plumpastry/PHW/README.md

# **P**lum's **H**ard**W**are

PHW-Board#-Part#-Revision#

## PHW-1-1-2:


NFC smartwatch development board

## PHW-1-1-1:



NFC smartwatch original board - infeasible manual assembly due to STM32WL
