plumpastry/PHW/nfc-watch/firmware/drv2625/readme.md

# A simple WIP Texas instruments DRV2625 driver
