plumpastry/PHW/nfc-watch/hardware/bom/pcb_bom.xlsx

Designator | Footprint | Quantity | Designation | Supplier and ref | Mouser P/N | Stock | Notes | Quantity Needed
C41,C42 | C_0402_1005Metric | 2 | 620pF |  | 81-GCM1555C1H621GA6D | 18 | 50VDC | 0
R7,R15,R4,R14,R8,R16 | R_0402_1005Metric | 6 | R10K |  | 71-CRCW040210K0FKEDC | 40 |  | 0
C24,C18,C37,C15,C23,C10,C14,C22,C9,C25 | C_0402_1005Metric | 10 | C0.1uF |  | 81-GRM15R61A104KA01J | 40 |  | 0
R1 | R_0402_1005Metric | 1 | R15k |  | 667-ERJ-PA2F1502X |  |  | 1
C38 | C_0402_1005Metric | 1 | C1uF |  | 81-GRM155C71C105ME11 | 9 |  | 0
PLUM FEEDBACK ENGINE | PUI_HD-LA0503-LW28 | 1 | HD-LA0503-LW28 |  | 665-HD-LA0503-LW28 | 1 |  | 0
C55 | C_0201_0603Metric | 1 | C0.3pF |  | 81-GCQ0335C1HR30BB1D |  |  | 1
C30,C32,C28,C34,C27,C36 | C_0201_0603Metric | 6 | C10nF |  | 963-JMK063BJ103KP-F |  | NFC DECOUPLING | 6 | NOTE: some parts footprints are wrong!!
C44,C43,C45,C1 | LXRW0YV201059 | 4 | LXRW0YV201-059 |  | 81-LXRW0YV201-059 | 0 |  | 4 | ALSO DECOUPLING PARTS FOR NFC MUSTS BE 6V RATED
IC4 | QFN50P400X400X90-25N-D | 1 | NPM1100-QDAA-R |  | 949-NPM1100-QDAA-R | 1 |  | 0
C4,C51,C8,C26,C3 | C_0402_1005Metric | 5 | C2.2uF |  | 81-GRT155R60J225KE1J |  |  | 5
C16,C29,C31,C33,C35 | C_0201_0603Metric | 5 | C2.2uF |  | 81-GRM033R60J225ME1D |  | NFC DECOUPLING | 5
C49,C47 | C_0402_1005Metric | 2 | 220pF |  | 81-GCM1555C2A221JE2D | 18 | 100VDC | 0
J3,J6,J5 | PinHeader_1x02_P2.54mm_Vertical | 3 | Conn_01x02_Pin |  | 649-1012937890203BLF |  |  | 3
C46,C48 | C_0402_1005Metric | 2 | 10pF |  | 81-GRM1555C2A100FA1D | 18 | 100VDC | 0
Y2 | Crystal_SMD_2016-4Pin_2.0x1.6mm | 1 | 32MHz |  | 581-CX2016SA32DFPLG1 |  |  | 1
C6,C2,C21,C5 | C_0402_1005Metric | 4 | C10uF |  | 81-GRM155R60J106ME8D | 7 | 10VDC FOR 9V RAIL | 0
IC3 | LSM6DS3USTR | 1 | ISM330DHCXTR |  | 511-ISM330DHCXTR |  |  | 1
R12,R11 | R_0402_1005Metric | 2 | R1.6 |  | 755-ESR01MZPJ1R6 | 8 |  | 0
C7, C17,C13,C11 | R_0402_1005Metric | 4 | C4.7uF |  | 81-GRM15D81C475ME15D | 0 |  | 4
PS1 | BGA6C40P2X3_88X123X62 | 1 | TPS61046YFFR |  | 595-TPS61046YFFR | 2 |  | 0
C50 | C_0402_1005Metric | 1 | C2.2nF |  | 710-885012205008 | 4 |  | 0
L4,L3 | L_0402_1005Metric | 2 | LEMC1 |  | 710-7447650227 |  |  | 2
R3 | C_0402_1005Metric | 1 | R1k |  | 603-RC0402FR-7D1KL |  |  | 1
J4 | PinHeader_2x10_P2.54mm_Vertical | 1 | Conn_02x10_Odd_Even |  | 649-1012938192001BLF | 0 |  | 1
C52 | C_0402_1005Metric | 1 | C3.9pF |  | KGM05ACG1H3R9BH | 0 |  | 1
ANT1 | ANTENNA_W3008 | 1 | W3008 |  | 673-W3008 | 0 |  | 1
TH1 | C_0201_0603Metric | 1 | NTC |  | 810-NTCG063JF103FT | 3 |  | 0
C39,C40 | C_0402_1005Metric | 2 | C12pF |  | 81-GRT1555C2A120JA2D | 16 |  | 0
Y1 | XRCGB | 1 | XRCGB27M120F3M13R0 |  | 81-XRCGB27M120F3M13R | 9 | 100VDC | 0
C53 | C_0201_0603Metric | 1 | C1.5pF |  | 81-GJM0335C1E1R5WB1D |  |  | 1
L2 | L_1008_2520Metric | 1 | L10uH |  | 81-1239AS-H-100MP2 | 3 |  | 0
AE1 | C_0805_2012Metric_Pad1.18x1.45mm_HandSolder | 1 | Antenna_Loop |  | 538-146236-0101 | 2 |  | 0
FB1 | L_0402_1005Metric | 1 | FerriteBead |  | 810-MPZ1005A151ETD25 | 3 |  | 0
FB2 | L_0402_1005Metric | 1 | FerriteBead |  | 81-BLM15AG121SN1D |  |  | 1
R6 | R_0402_1005Metric | 1 | R510K |  | 71-CRCW0402510KFKED | 9 |  | 0
L8,L7 | C_0402_1005Metric | 2 | L3.5nH |  | 81-LQP03HQ3N5B02D |  |  | 2
R5 | R_0402_1005Metric | 1 | R75K |  | 71-RCG040275K0JNED | 9 |  | 0
L6 | C_0402_1005Metric | 1 | L2.7nH |  | 81-LQP03HQ2N7B02D |  |  | 1
SW4,SW3,SW2 | SW_B3U-1100P | 3 | SW_Push |  | 653-B3U-1100P |  |  | 3
IC2 | QFN50P500X500X60-33N-D | 1 | ST25R3916B-AQET |  | 511-ST25R3916B-AQET | 1 |  | 0
J2 | 2121340002 | 1 | 212134-0002 |  | 538-212134-0002 | 3 |  | 0
C54 | C_0201_0603Metric | 1 | C2.0pF |  | 81-GJM0335C1E2R0WB1D |  |  | 1
L1 | L_0805_2012Metric | 1 |  |  | 810-MLP2012V2R2MT0S1 | 3 |  | 0
L5 | L_0603_1608Metric | 1 | L4.7uH |  | 81-LQM18PH4R7MFRL |  |  | 1
R2 | R_0402_1005Metric | 1 | R750K |  | 71-CRCW0402750KFKEDC | 9 |  | 0
U2 | QFN-48-1EP_6x6mm_P0.4mm_EP4.6x4.6mm | 1 | NRF54L15-QFAA-R |  | 949-NRF54L15-QFAA-R | 0 |  | 1
SW1 | alps_ec05e | 1 | RotaryEncoder |  | 688-EC05E1220202 | 0 |  | 1
IC1 | BGA9C40P3X3_147X133X62 | 1 | DRV2625YFFR |  | 595-DRV2625YFFR | 2 |  | 0
