plumpastry/PHW/nfc-watch/hardware/symbols/alps/EC05E1220202/ec05e1220202.obj

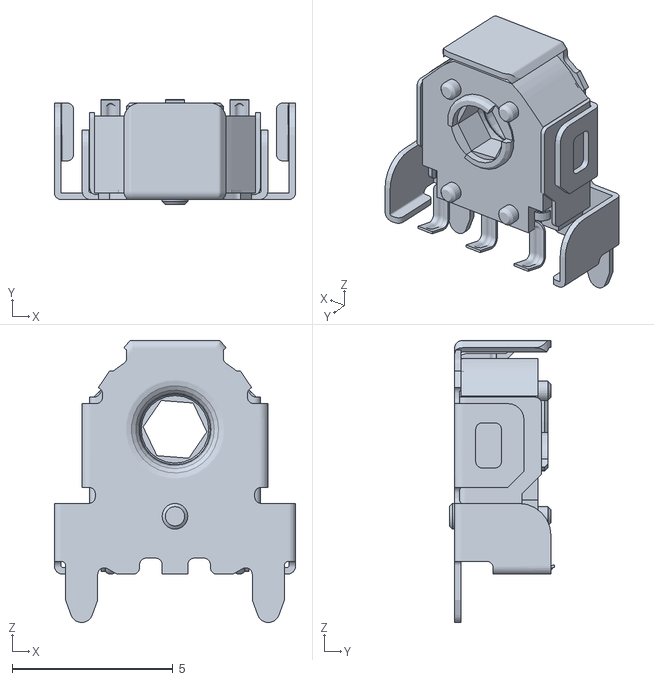
[picture p1: CAD file, 2026-02-17]
nfc-watch/hardware/symbols/alps/EC05E1220202/ec05e1220202.obj
7.50 x 3.27 x 8.76
