plumpastry/PHW/nfc-watch/hardware/symbols/B3U_1100P/B3U-1100P.step

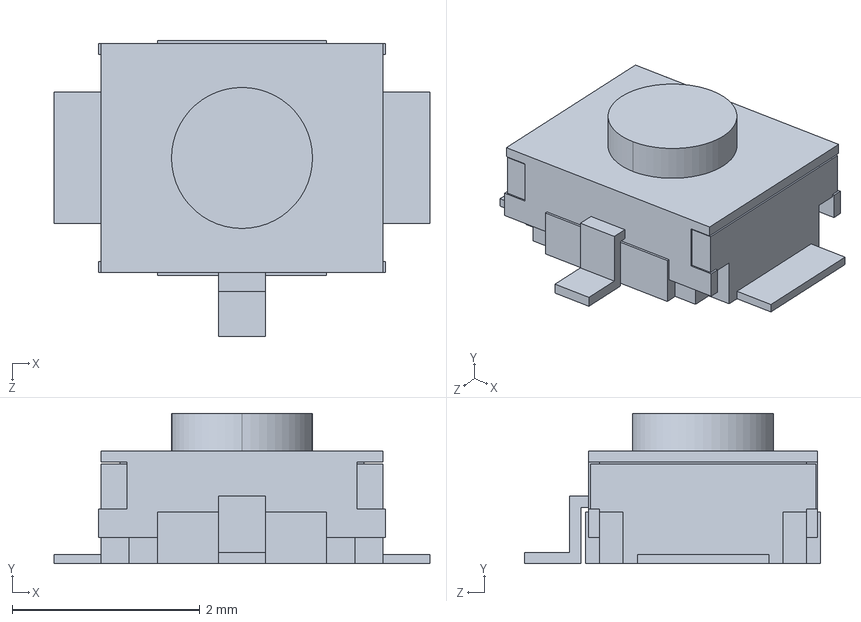
[picture p2: CAD file, 2026-02-17]
nfc-watch/hardware/symbols/B3U_1100P/B3U-1100P.step
4.00 x 1.60 x 3.15 mm
