plumpastry/PHW/nfc-watch/hardware/symbols/CX90B_16P1(2)/CX90B-16P1.step

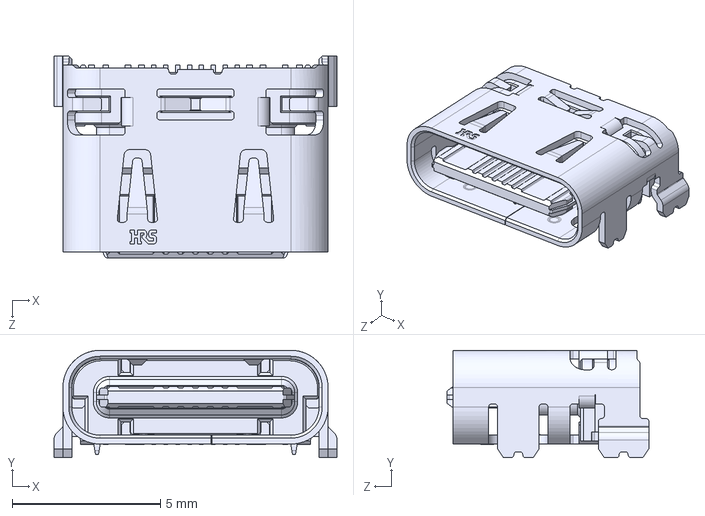
[picture p3: CAD file, 2026-02-17]
nfc-watch/hardware/symbols/CX90B_16P1(2)/CX90B-16P1.step
9.54 x 3.62 x 6.80 mm
