plumpastry/PHW/nfc-watch/hardware/symbols/disp.obj

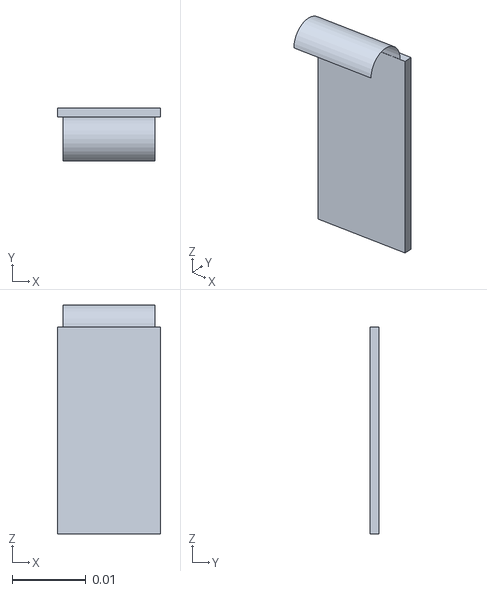
[picture p4: CAD file, 2026-02-17]
nfc-watch/hardware/symbols/disp.obj
0.014 x 0.00724 x 0.031
