plumpastry/PHW/nfc-watch/hardware/symbols/HD_LA0503_LW28/HD-LA0503-LW28.step

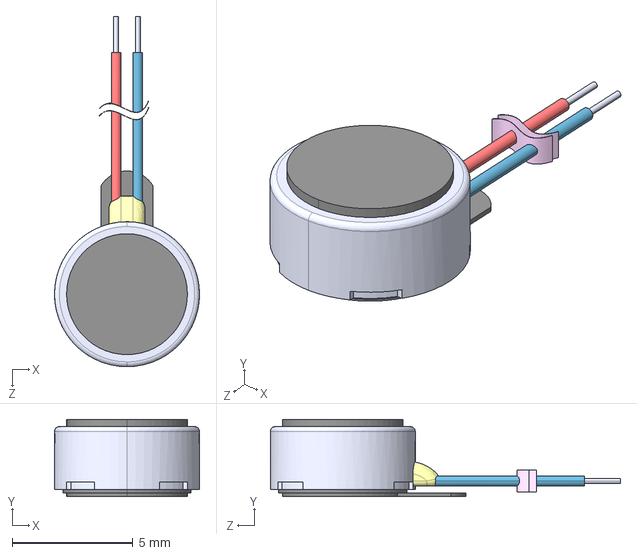
[picture p5: CAD file, 2026-02-17]
nfc-watch/hardware/symbols/HD_LA0503_LW28/HD-LA0503-LW28.step
6.00 x 3.20 x 14.5 mm
