plumpastry/PHW/nfc-watch/hardware/symbols/LIB_DRV2625YFFR/DRV2625YFFR/3D/DRV2625YFFR.stp

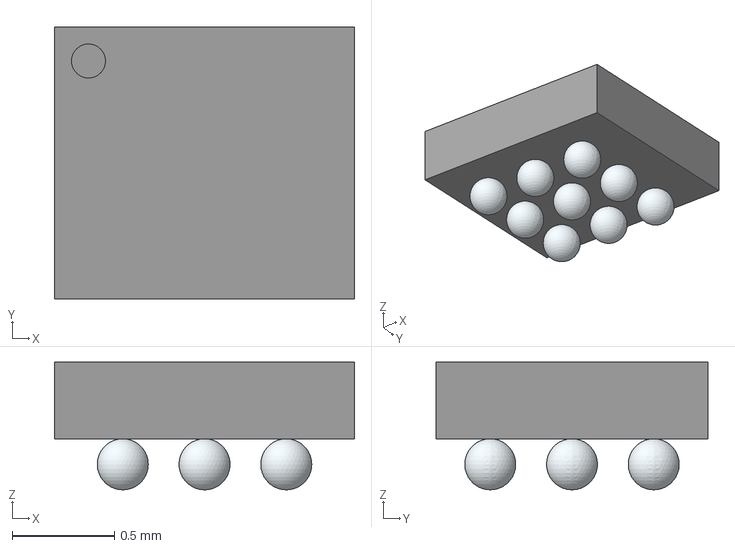
[picture p6: CAD file, 2026-02-17]
nfc-watch/hardware/symbols/LIB_DRV2625YFFR/DRV2625YFFR/3D/DRV2625YFFR.stp
1.47 x 1.33 x 0.625 mm
