plumpastry/PHW/nfc-watch/hardware/symbols/LIB_ISM330DHCXTR(1)/ISM330DHCXTR/3D/ISM330DHCXTR.stp

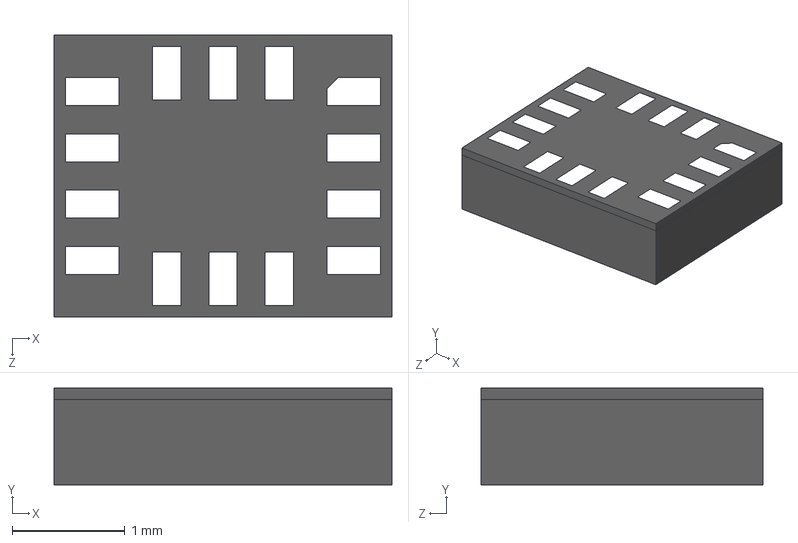
[picture p7: CAD file, 2026-02-17]
nfc-watch/hardware/symbols/LIB_ISM330DHCXTR(1)/ISM330DHCXTR/3D/ISM330DHCXTR.stp
3.00 x 0.86 x 2.50 mm
