plumpastry/PHW/nfc-watch/hardware/symbols/LIB_NPM1100-QDAA-R/NPM1100-QDAA-R/3D/NPM1100-QDAA-R.stp

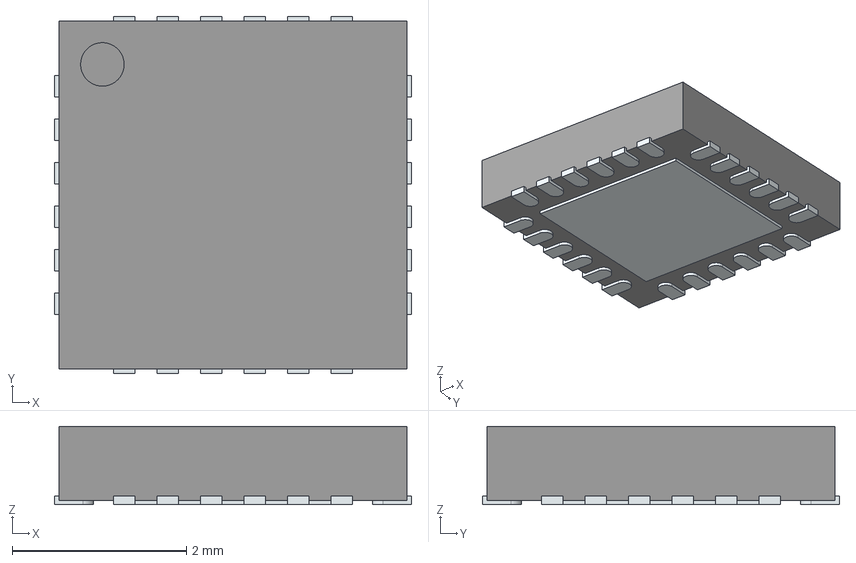
[picture p8: CAD file, 2026-02-17]
nfc-watch/hardware/symbols/LIB_NPM1100-QDAA-R/NPM1100-QDAA-R/3D/NPM1100-QDAA-R.stp
4.10 x 4.10 x 0.9 mm
ThermalPin
PinsArrayLR
PinsArrayTB
