plumpastry/PHW/nfc-watch/hardware/symbols/LIB_ST25R3916B-AQET(1)/ST25R3916B-AQET/3D/ST25R3916B-AQET.stp

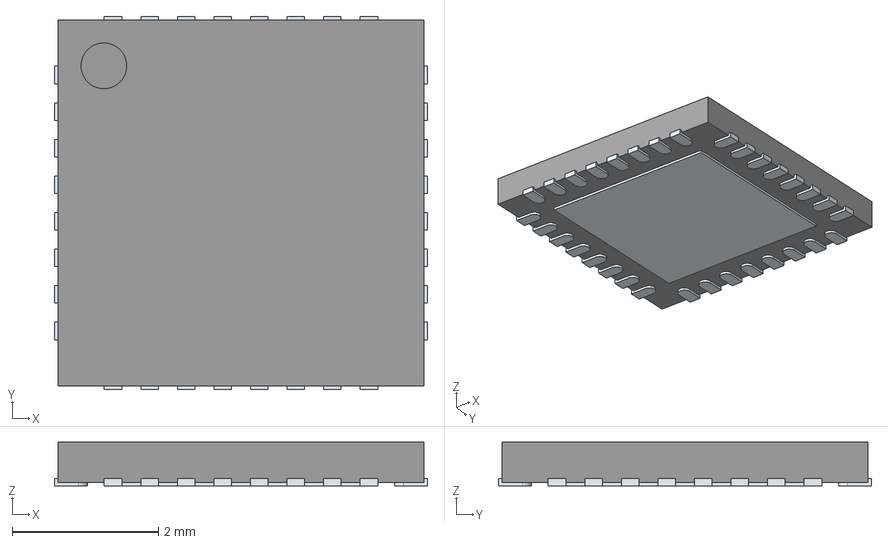
[picture p9: CAD file, 2026-02-17]
nfc-watch/hardware/symbols/LIB_ST25R3916B-AQET(1)/ST25R3916B-AQET/3D/ST25R3916B-AQET.stp
5.10 x 5.10 x 0.6 mm
ThermalPin
PinsArrayLR
PinsArrayTB
