plumpastry/PHW/nfc-watch/hardware/symbols/LIB_ST25R3916B-BWLT/ST25R3916B-BWLT/3D/ST25R3916B-BWLT.stp

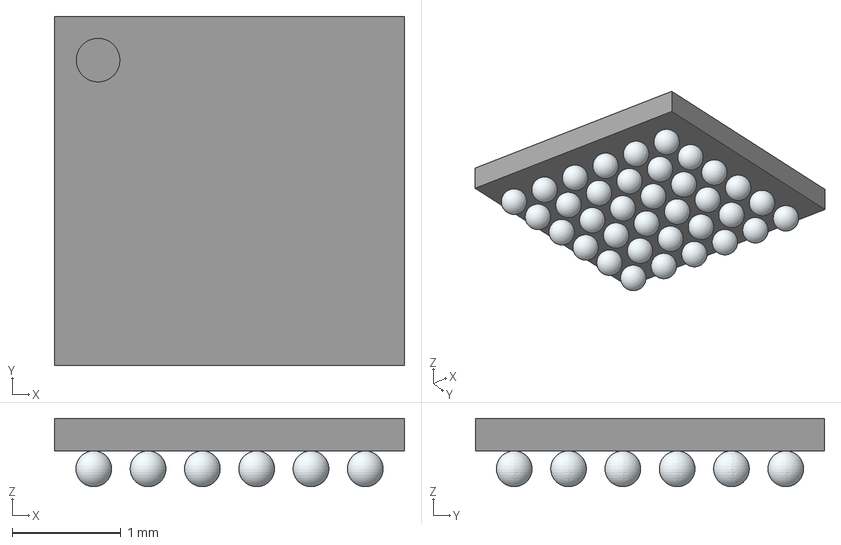
[picture p10: CAD file, 2026-02-17]
nfc-watch/hardware/symbols/LIB_ST25R3916B-BWLT/ST25R3916B-BWLT/3D/ST25R3916B-BWLT.stp
3.22 x 3.21 x 0.63 mm
