plumpastry/PHW/nfc-watch/hardware/symbols/LIB_XRCGB27M120F3M13R0(1)/XRCGB27M120F3M13R0/3D/XRCGB27M120F3M13R0.stp

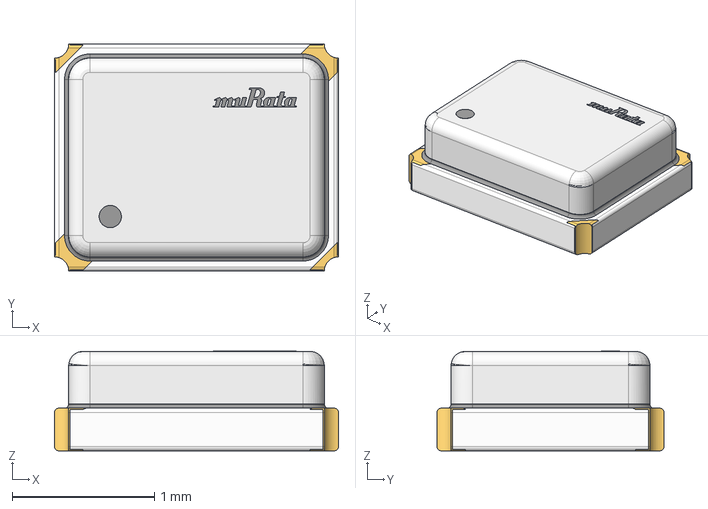
[picture p11: CAD file, 2026-02-17]
nfc-watch/hardware/symbols/LIB_XRCGB27M120F3M13R0(1)/XRCGB27M120F3M13R0/3D/XRCGB27M120F3M13R0.stp
2.00 x 1.60 x 0.702 mm
