plumpastry/PHW/nfc-watch/hardware/symbols/NRF54L15_QFAA_R/QFN48_6X6_NOR.step

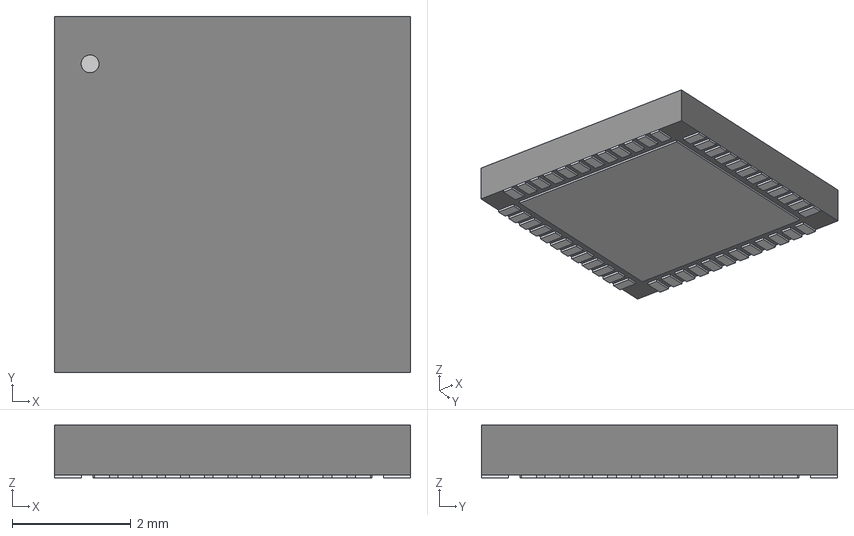
[picture p12: CAD file, 2026-02-17]
nfc-watch/hardware/symbols/NRF54L15_QFAA_R/QFN48_6X6_NOR.step
5.99 x 5.99 x 0.892 mm
