plumpastry/PHW/nfc-watch/hardware/symbols/STM32WB1MMCH6TR/KiCADv6/LIB_STM32WB1MMCH6TR(2)/STM32WB1MMCH6TR/3D/STM32WB1MMCH6TR.stp

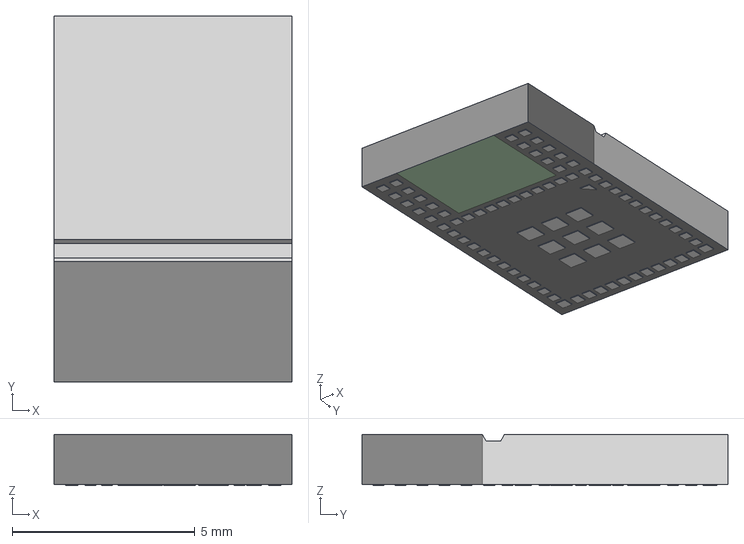
[picture p13: CAD file, 2026-02-17]
nfc-watch/hardware/symbols/STM32WB1MMCH6TR/KiCADv6/LIB_STM32WB1MMCH6TR(2)/STM32WB1MMCH6TR/3D/STM32WB1MMCH6TR.stp
6.50 x 10.0 x 1.40 mm
