plumpastry/PHW/nfc-watch/hardware/symbols/W3008(1)/W3008.step

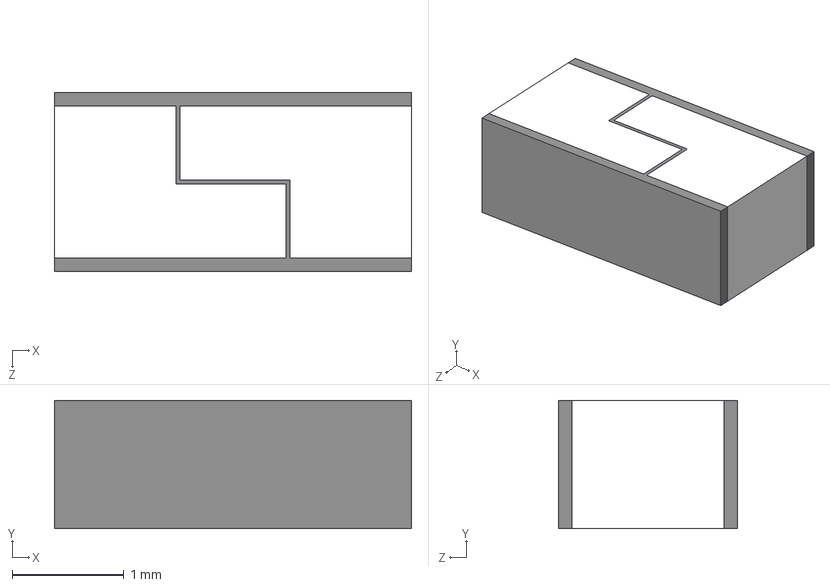
[picture p14: CAD file, 2026-02-17]
nfc-watch/hardware/symbols/W3008(1)/W3008.step
3.20 x 1.15 x 1.60 mm
