plumpastry/PHW/nfc-watch/hardware/symbols/LIB_212134-0002(1)/212134-0002/3D/212134-0002.stp

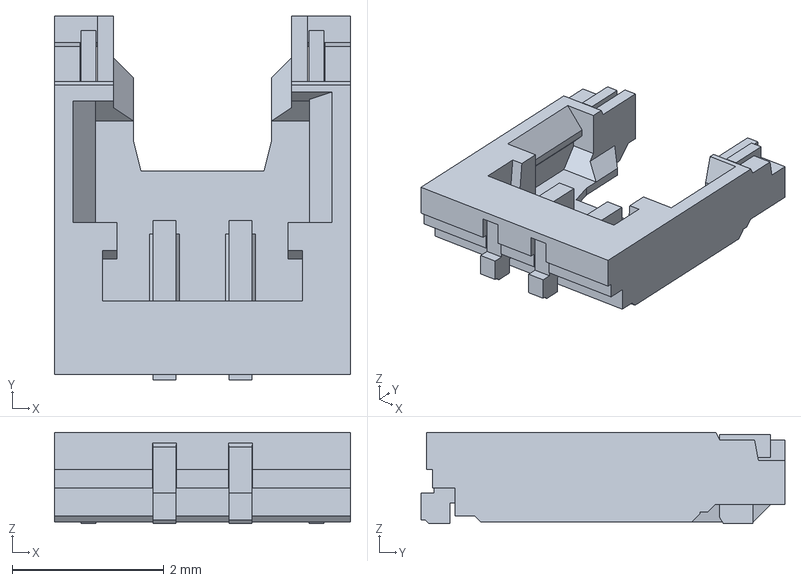
[picture p15: CAD file, 2026-02-17]
nfc-watch/hardware/symbols/LIB_212134-0002(1)/212134-0002/3D/212134-0002.stp
3.90 x 4.79 x 1.20 mm
