plumpastry/PHW/nfc-watch/hardware/symbols/LIB_TPS61046YFFR/TPS61046YFFR/3D/TPS61046YFFR.stp

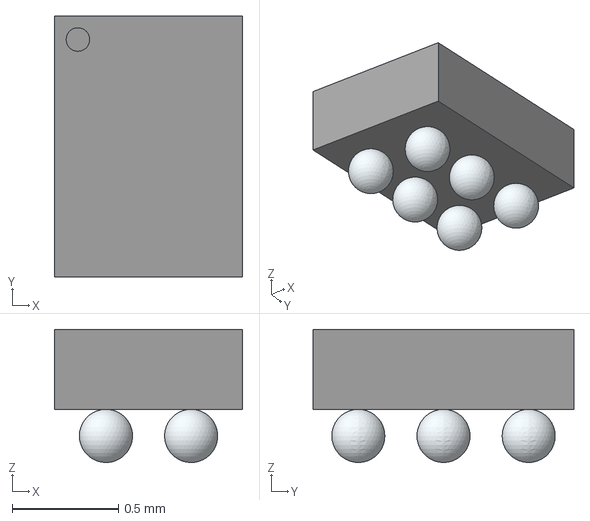
[picture p16: CAD file, 2026-02-17]
nfc-watch/hardware/symbols/LIB_TPS61046YFFR/TPS61046YFFR/3D/TPS61046YFFR.stp
0.884 x 1.23 x 0.625 mm
