plumpastry/PHW/(list of files, cad)

Other CAD files:
nfc-watch/hardware/symbols/alps/LIB_EC05E1220202/EC05E1220202/3D/EC05E1220202.stp
nfc-watch/hardware/symbols/LIB_212134-0002(1)/212134-0002/Allegro/2121340002.psm
nfc-watch/hardware/symbols/LIB_212134-0002(1)/212134-0002/DEHDL/212134_0002/chips/chips.prt
nfc-watch/hardware/symbols/LIB_DRV2625YFFR/DRV2625YFFR/Allegro/bga9c40p3x3_147x133x62.psm
nfc-watch/hardware/symbols/LIB_DRV2625YFFR/DRV2625YFFR/DEHDL/drv2625yffr/chips/chips.prt
nfc-watch/hardware/symbols/LIB_ISM330DHCXTR(1)/ISM330DHCXTR/Allegro/lsm6ds3ustr.psm
nfc-watch/hardware/symbols/LIB_ISM330DHCXTR(1)/ISM330DHCXTR/DEHDL/ism330dhcxtr/chips/chips.prt
nfc-watch/hardware/symbols/LIB_LXRW0YV201-059(1)/LXRW0YV201-059/Allegro/lxrw0yv201059.psm
nfc-watch/hardware/symbols/LIB_LXRW0YV201-059(1)/LXRW0YV201-059/DEHDL/lxrw0yv201_059/chips/chips.prt
nfc-watch/hardware/symbols/LIB_NPM1100-QDAA-R/NPM1100-QDAA-R/Allegro/qfn50p400x400x90-25n-d.psm
nfc-watch/hardware/symbols/LIB_NPM1100-QDAA-R/NPM1100-QDAA-R/DEHDL/npm1100_qdaa_r/chips/chips.prt
nfc-watch/hardware/symbols/LIB_ST25R3916B-AQET(1)/ST25R3916B-AQET/Allegro/qfn50p500x500x60-33n-d.psm
nfc-watch/hardware/symbols/LIB_ST25R3916B-AQET(1)/ST25R3916B-AQET/DEHDL/st25r3916b_aqet/chips/chips.prt
nfc-watch/hardware/symbols/LIB_ST25R3916B-BWLT/ST25R3916B-BWLT/Allegro/bga36c50p6x6_322x321x63.psm
nfc-watch/hardware/symbols/LIB_ST25R3916B-BWLT/ST25R3916B-BWLT/DEHDL/st25r3916b_bwlt/chips/chips.prt
nfc-watch/hardware/symbols/LIB_TPS61046YFFR/TPS61046YFFR/Allegro/bga6c40p2x3_88x123x62.psm
nfc-watch/hardware/symbols/LIB_TPS61046YFFR/TPS61046YFFR/DEHDL/tps61046yffr/chips/chips.prt
nfc-watch/hardware/symbols/LIB_XRCGB27M120F3M13R0(1)/XRCGB27M120F3M13R0/Allegro/xrcgb.psm
nfc-watch/hardware/symbols/LIB_XRCGB27M120F3M13R0(1)/XRCGB27M120F3M13R0/DEHDL/xrcgb27m120f3m13r0/chips/chips.prt
