plumpastry/PHW/nfc-watch/hardware/watch.kicad_pcb

## KiCad design nfc-watch/hardware/watch.kicad_pcb (2026-02-17)

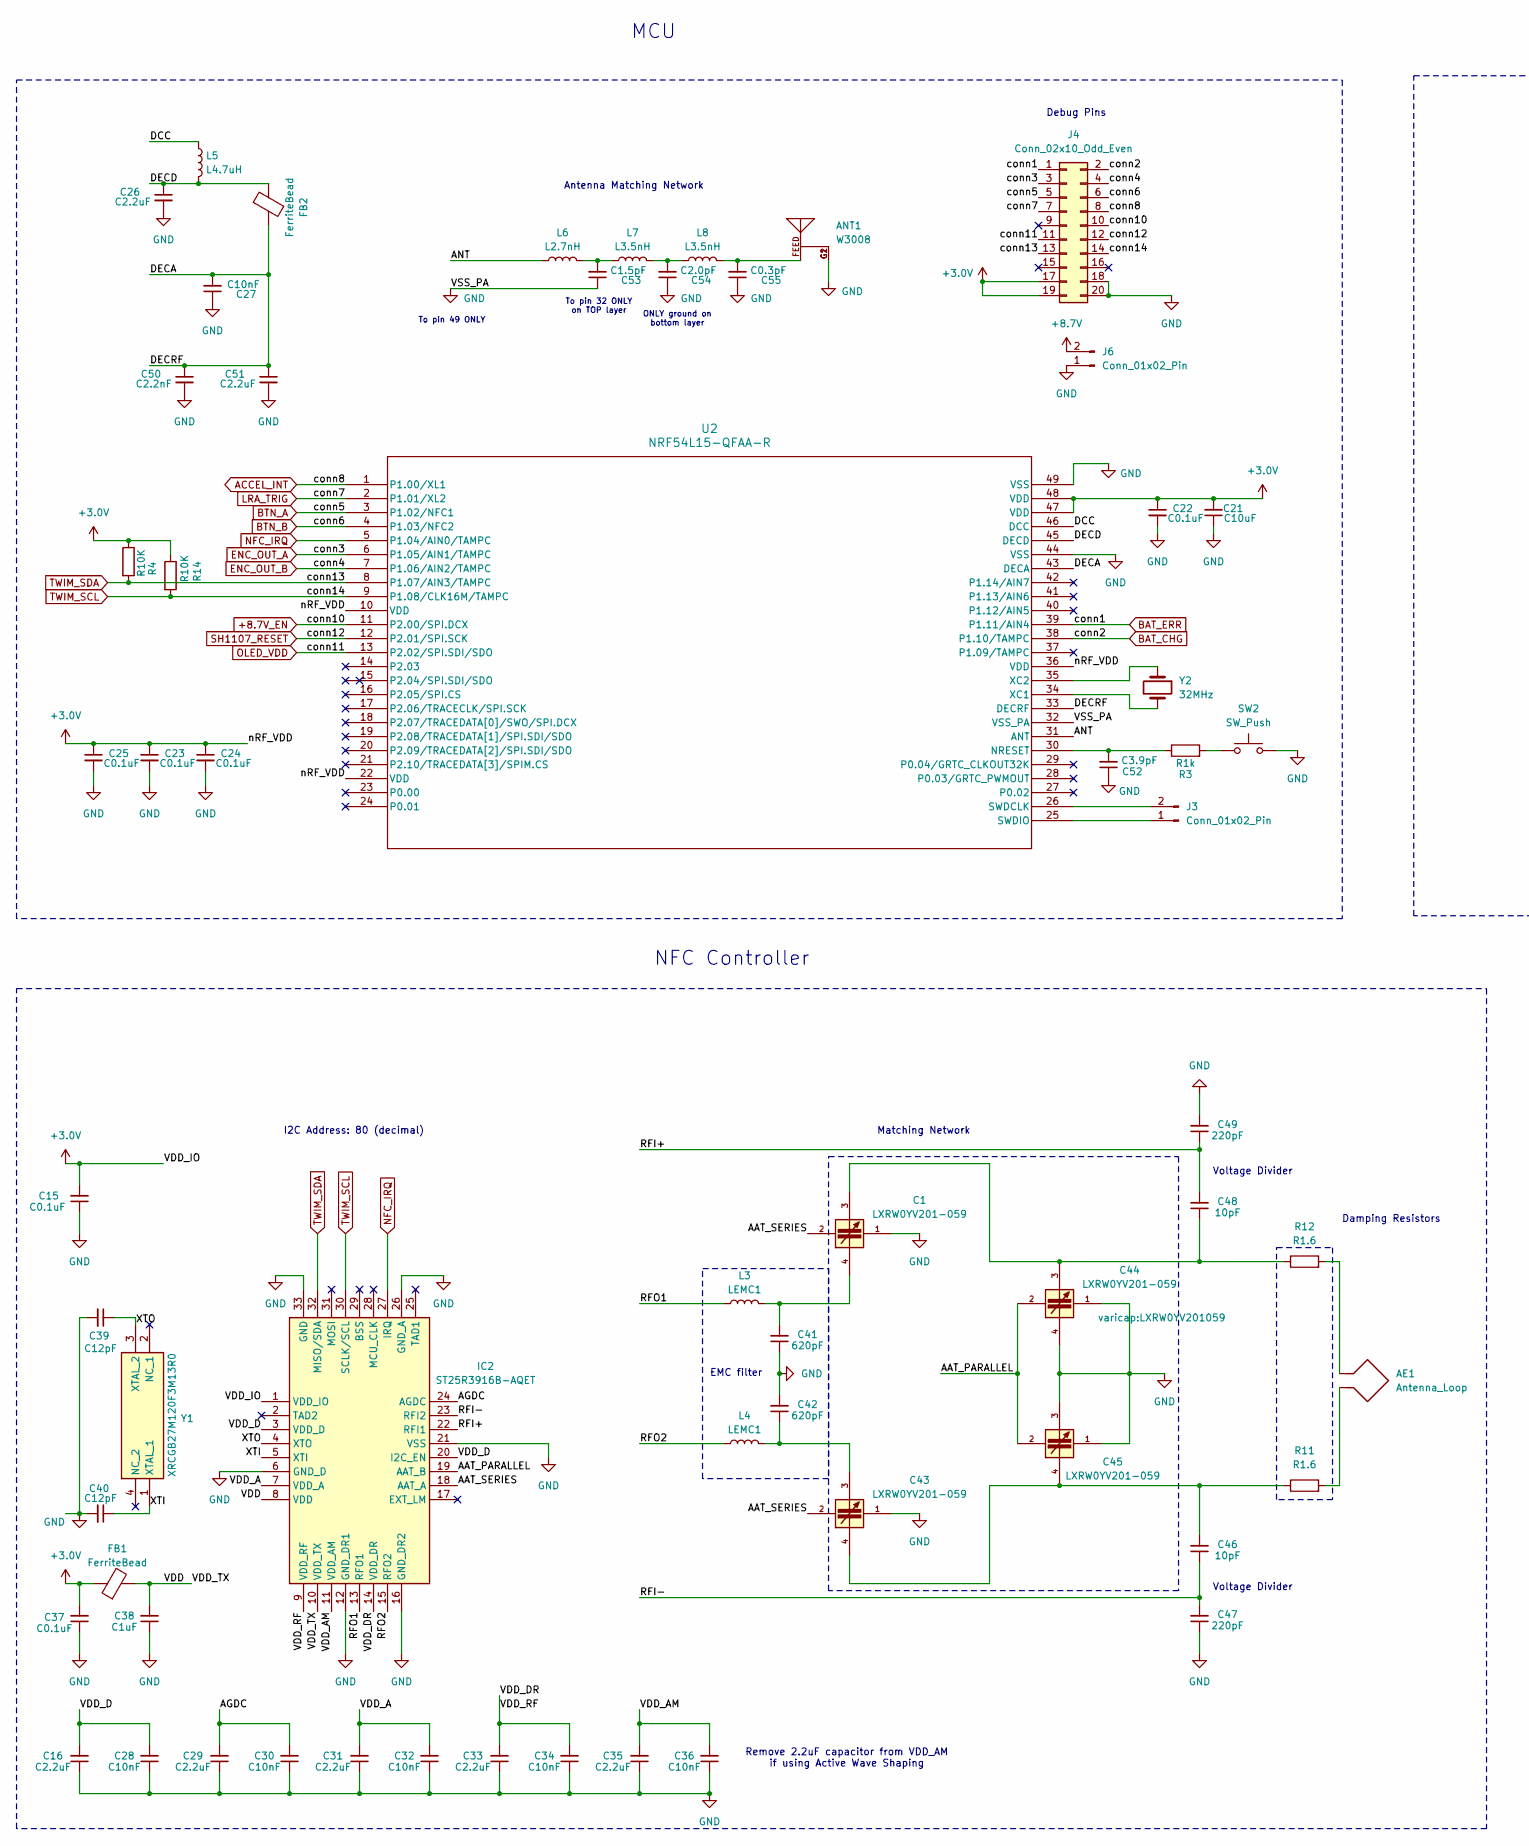
[picture p17: schematic watch.kicad_sch, Watch EVE, part in row 1, column 1]

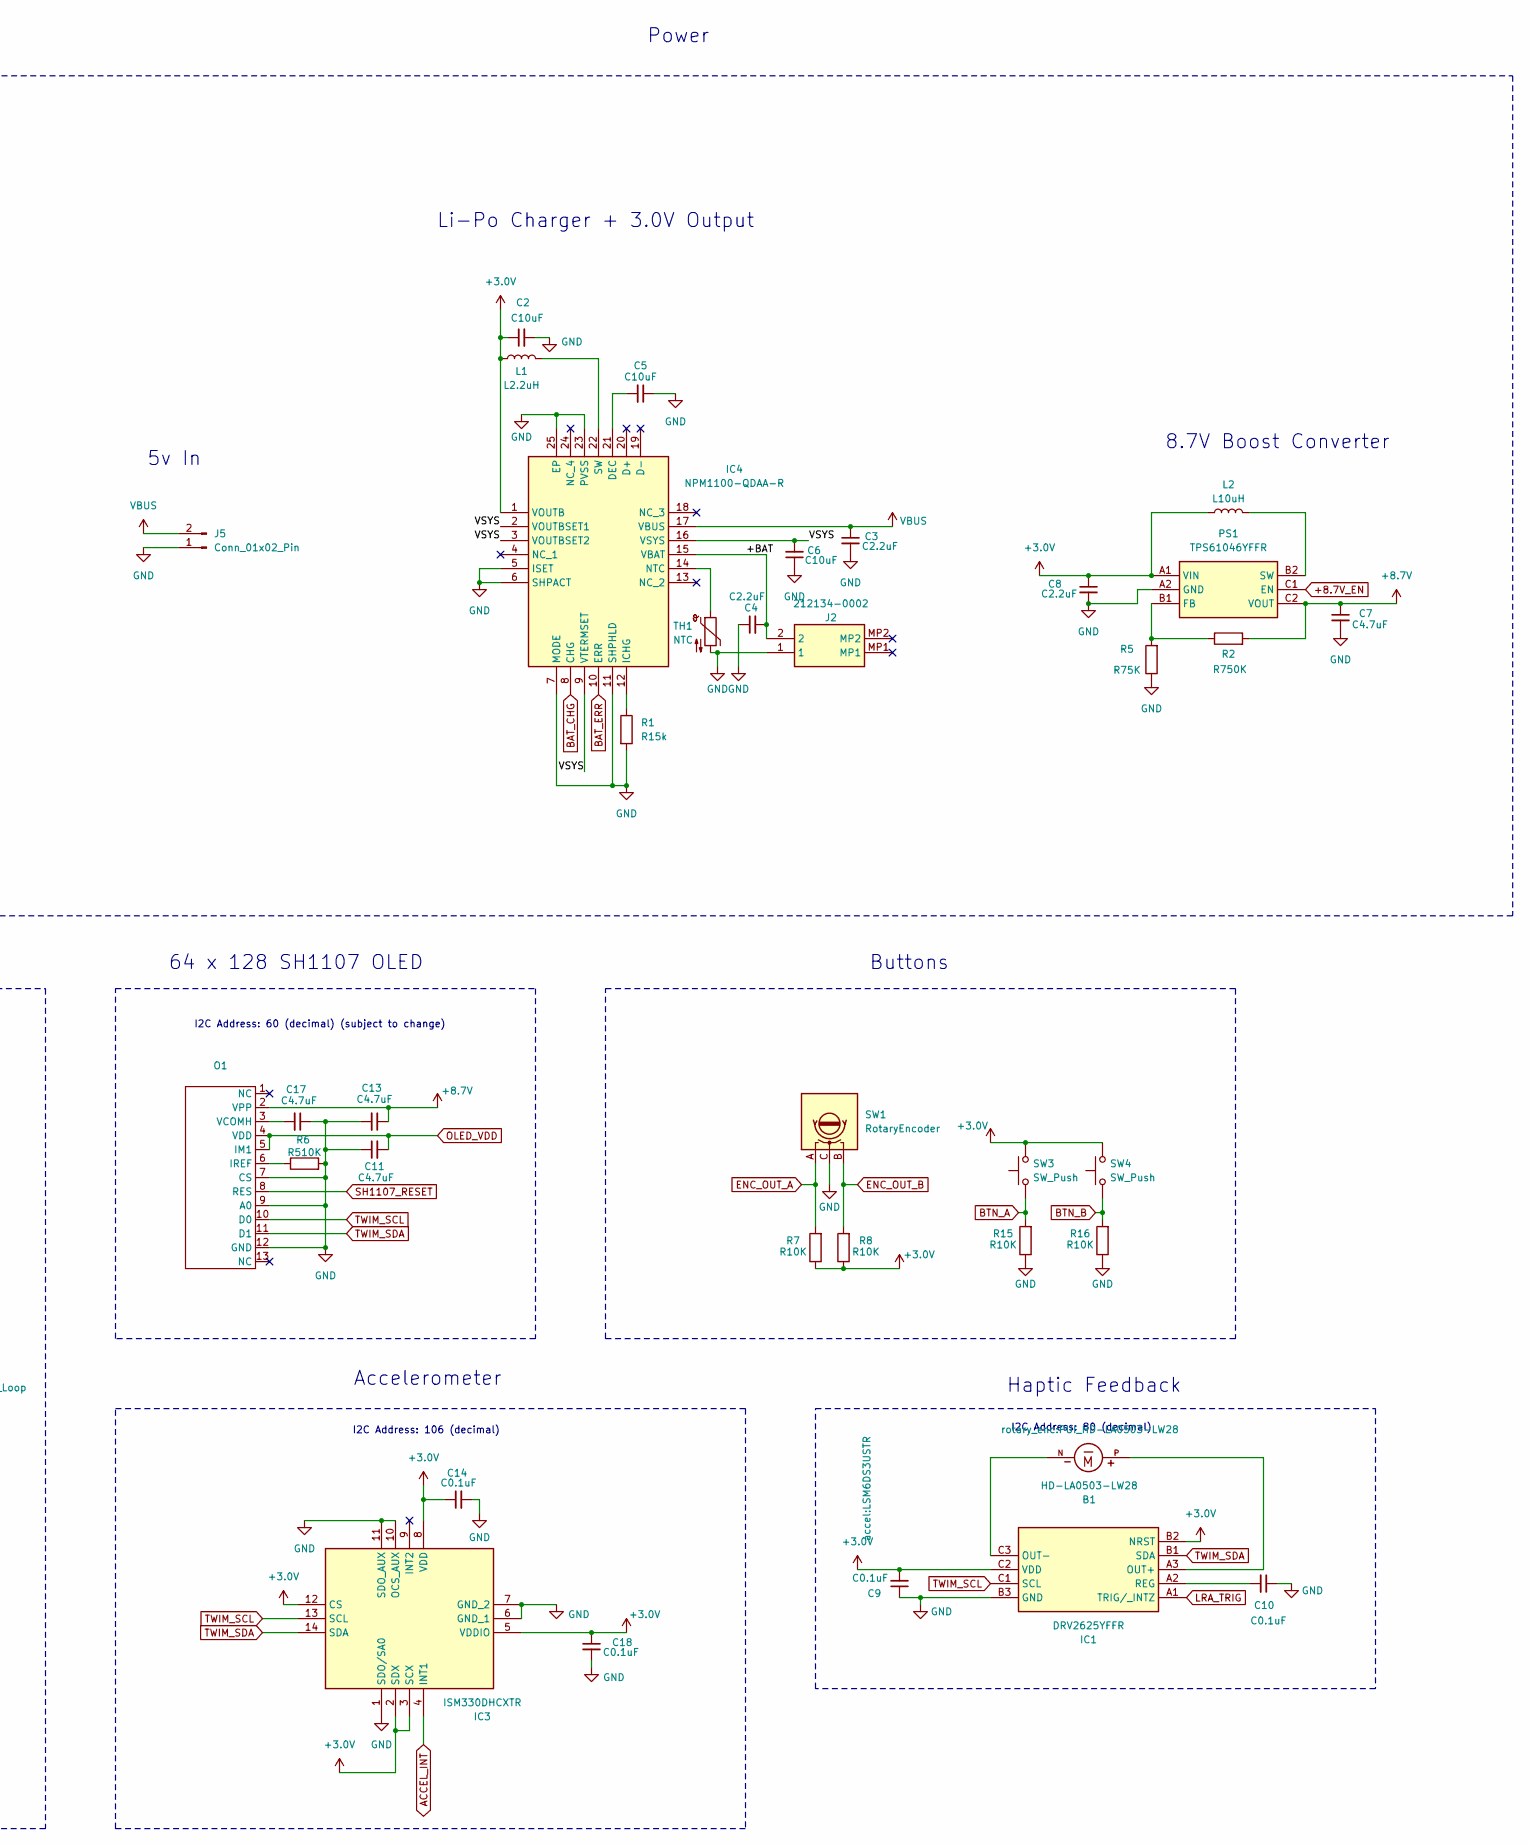
[picture p18: schematic watch.kicad_sch, Watch EVE, part in row 1, column 2]

Parts:
AE1: Antenna_Loop; C_0603_1608Metric
ANT1: W3008; ANTENNA_W3008
B1: HD-LA0503-LW28; PUI_HD-LA0503-LW28; PARTREV A
C1, C43, C44, C45: LXRW0YV201-059; LXRW0YV201059; PARTREV July, 2018
C2, C5, C6, C21: C10uF; C_0402_1005Metric
C3, C4, C8, C26, C51: C2.2uF; C_0402_1005Metric
C7, C11, C13, C17: C4.7uF; C_0402_1005Metric
C9, C10, C14, C15, C18, C22, C23, C24, C25, C37: C0.1uF; C_0402_1005Metric
C16, C29, C31, C33, C35: C2.2uF; C_0201_0603Metric
C27, C28, C30, C32, C34, C36: C10nF; C_0201_0603Metric
C38: C1uF; C_0402_1005Metric
C39, C40: C12pF; C_0402_1005Metric
C41, C42: 620pF; C_0402_1005Metric
C46, C48: 10pF; C_0402_1005Metric
C47, C49: 220pF; C_0402_1005Metric
C50: C2.2nF; C_0402_1005Metric
C52: C3.9pF; C_0402_1005Metric
C53: C1.5pF; C_0201_0603Metric
C54: C2.0pF; C_0201_0603Metric
C55: C0.3pF; C_0201_0603Metric
FB1, FB2: FerriteBead; L_0402_1005Metric
IC1: DRV2625YFFR; BGA9C40P3X3_147X133X62; Mouser Part Number 595-DRV2625YFFR
IC2: ST25R3916B-AQET; QFN50P500X500X60-33N-D; Mouser Part Number 511-ST25R3916B-AQET
IC3: ISM330DHCXTR; LSM6DS3USTR; Mouser Part Number 511-ISM330DHCXTR
IC4: NPM1100-QDAA-R; QFN50P400X400X90-25N-D; Mouser Part Number 949-NPM1100-QDAA-R
J2: 212134-0002; 2121340002; Mouser Part Number 538-212134-0002
J3, J5, J6: Conn_01x02_Pin; PinHeader_1x02_P2.54mm_Vertical
J4: Conn_02x10_Odd_Even; PinHeader_2x10_P2.54mm_Vertical
L1: L2.2uH; L_0805_2012Metric
L2: L10uH; L_1008_2520Metric
L3, L4: LEMC1; L_0402_1005Metric
L5: L4.7uH; L_0603_1608Metric
L6: L2.7nH; L_0201_0603Metric
L7, L8: L3.5nH; L_0201_0603Metric
O1: P0.7_FPC
PS1: TPS61046YFFR; BGA6C40P2X3_88X123X62; Mouser Part Number 595-TPS61046YFFR
R1: R15k; R_0402_1005Metric
R2: R750K; R_0402_1005Metric
R3: R1k; C_0402_1005Metric
R4, R7, R8, R14, R15, R16: R10K; R_0402_1005Metric
R5: R75K; R_0402_1005Metric
R6: R510K; R_0402_1005Metric
R11, R12: R1.6; R_0402_1005Metric
SW1: RotaryEncoder; alps_ec05e
SW2, SW3, SW4: SW_Push; SW_B3U-1100P
TH1: NTC; C_0201_0603Metric
U2: NRF54L15-QFAA-R; QFN-48-1EP_6x6mm_P0.4mm_EP4.6x4.6mm
Y1: XRCGB27M120F3M13R0; XRCGB; Mouser Part Number 81-XRCGB27M120F3M13R
Y2: 32MHz; Crystal_SMD_2016-4Pin_2.0x1.6mm

Connections:
+3.0V: C2.1, C8.1, C9.2, C14.1, C15.2, C18.1, C21.2, C22.1, C23.1, C24.1, C25.1, C37.2, FB1.1, IC1.B2 (NRST), IC1.C2 (VDD), IC2.1 (VDD_IO), IC3.2 (SDX), IC3.3 (SCX), IC3.5 (VDDIO), IC3.8 (VDD), IC3.12 (CS), IC4.1 (VOUTB), J4.17, J4.19, L1.1, L2.1, PS1.A1 (VIN), R4.1, R7.1, R8.1, R14.1, SW3.2, SW4.2, U2.10 (VDD), U2.22 (VDD), U2.36 (VDD), U2.47 (VDD), U2.48 (VDD)
+8.7V: C7.1, C13.1, J6.2, O1.2 (VPP), PS1.C2 (VOUT), R2.2
+8.7V_EN: J4.10, PS1.C1 (EN), U2.11 (P2.00/SPI.DCX)
/+BAT: C4.2, IC4.15 (VBAT), J2.2
/AAT_PARALLEL: C44.2, C45.2, IC2.19 (AAT_B)
/AAT_SERIES: C1.2, C43.2, IC2.18 (AAT_A)
/AGDC: C29.2, C30.2, IC2.24 (AGDC)
/ANT: L6.1, U2.31 (ANT)
/DCC: L5.1, U2.46 (DCC)
/DECA: C27.2, C50.1, C51.1, FB2.2, U2.33 (DECRF), U2.43 (DECA)
/DECD: C26.1, FB2.1, L5.2, U2.45 (DECD)
/RFI+: C48.2, C49.1, IC2.22 (RFI1)
/RFI-: C46.1, C47.2, IC2.23 (RFI2)
/RFO1: IC2.13 (RFO1), L3.1
/RFO2: IC2.15 (RFO2), L4.1
/VDD: C38.2, FB1.2, IC2.8 (VDD), IC2.10 (VDD_TX)
/VDD_A: C31.2, C32.2, IC2.7 (VDD_A)
/VDD_AM: C35.2, C36.2, IC2.11 (VDD_AM)
/VDD_D: C16.2, C28.2, IC2.3 (VDD_D), IC2.20 (I2C_EN)
/VDD_DR: C33.2, C34.2, IC2.9 (VDD_RF), IC2.14 (VDD_DR)
/VSYS: C6.2, IC4.2 (VOUTBSET1), IC4.3 (VOUTBSET2), IC4.9 (VTERMSET), IC4.16 (VSYS)
/XTI: C40.1, IC2.5 (XTI), Y1.1 (XTAL_1)
/XTO: C39.1, IC2.4 (XTO), Y1.3 (XTAL_2)
ACCEL_INT: IC3.4 (INT1), J4.8, U2.1 (P1.00/XL1)
BAT_CHG: IC4.8 (CHG), J4.2, U2.38 (P1.10/TAMPC)
BAT_ERR: IC4.10 (ERR), J4.1, U2.39 (P1.11/AIN4)
BTN_A: J4.5, R15.2, SW3.1, U2.3 (P1.02/NFC1)
BTN_B: J4.6, R16.2, SW4.1, U2.4 (P1.03/NFC2)
ENC_OUT_A: J4.3, R7.2, SW1.A, U2.6 (P1.05/AIN1/TAMPC)
ENC_OUT_B: J4.4, R8.2, SW1.B, U2.7 (P1.06/AIN2/TAMPC)
GND: ANT1.G1, ANT1.G2, C1.1, C2.2, C3.2, C4.1, C5.1, C6.1, C7.2, C8.2, C9.1, C10.1, C11.1, C13.2, C14.2, C15.1, C16.1, C17.1, C18.2, C21.1, C22.2, C23.2, C24.2, C25.2, C26.2, C27.1, C28.1, C29.1, C30.1, C31.1, C32.1, C33.1, C34.1, C35.1, C36.1, C37.1, C38.1, C39.2, C40.2, C41.1, C42.2, C43.1, C44.1, C44.4, C45.1, C45.3, C47.1, C49.2, C50.2, C51.2, C52.1, C53.1, C54.1, C55.1, IC1.B3 (GND), IC2.6 (GND_D), IC2.12 (GND_DR1), IC2.16 (GND_DR2), IC2.21 (VSS), IC2.26 (GND_A), IC2.33 (GND), IC3.1 (SDO/SA0), IC3.6 (GND_1), IC3.7 (GND_2), IC3.10 (OCS_AUX), IC3.11 (SDO_AUX), IC4.5 (ISET), IC4.6 (SHPACT), IC4.7 (MODE), IC4.11 (SHPHLD), IC4.23 (PVSS), IC4.25 (EP), J2.1, J4.18, J4.20, J5.1, J6.1, O1.7 (CS), O1.9 (A0), O1.12 (GND), PS1.A2 (GND), R1.2, R5.1, R6.2, R15.1, R16.1, SW1.C, SW2.2, TH1.2, U2.32 (VSS_PA), U2.44 (VSS), U2.49 (VSS)
LRA_TRIG: IC1.A1 (TRIG/_INTZ), J4.7, U2.2 (P1.01/XL2)
NFC_IRQ: IC2.27 (IRQ), U2.5 (P1.04/AIN0/TAMPC)
unnamed: AE1.1, R12.2
unnamed: AE1.2, R11.2
unnamed: ANT1.FEED, C55.2, L8.2
unnamed: C1.3, C44.3, C48.1, R12.1
unnamed: C1.4, C41.2, L3.2
unnamed: C42.1, C43.3, L4.2
unnamed: C43.4, C45.4, C46.2, R11.1
unnamed: C53.2, L6.2, L7.1
unnamed: C54.2, L7.2, L8.1
unnamed: B1.P, IC1.A3 (OUT+)
unnamed: B1.N, IC1.C3 (OUT-)
unnamed: C10.2, IC1.A2 (REG)
unnamed: C5.2, IC4.21 (DEC)
unnamed: IC4.12 (ICHG), R1.1
unnamed: IC4.14 (NTC), TH1.1
unnamed: IC4.22 (SW), L1.2
unnamed: J3.1, U2.25 (SWDIO)
unnamed: J3.2, U2.26 (SWDCLK)
unnamed: O1.6 (IREF), R6.1
unnamed: C17.2, O1.3 (VCOMH)
unnamed: PS1.B1 (FB), R2.1, R5.2
unnamed: L2.2, PS1.B2 (SW)
unnamed: R3.2, SW2.1
unnamed: C52.2, R3.1, U2.30 (NRESET)
unnamed: U2.34 (XC1), Y2.2
unnamed: U2.35 (XC2), Y2.1
OLED_VDD: C11.2, J4.11, O1.4 (VDD), O1.5 (IM1), U2.13 (P2.02/SPI.SDI/SDO)
SH1107_RESET: J4.12, O1.8 (RES), U2.12 (P2.01/SPI.SCK)
TWIM_SCL: IC1.C1 (SCL), IC2.30 (SCLK/SCL), IC3.13 (SCL), J4.14, O1.10 (D0), R14.2, U2.9 (P1.08/CLK16M/TAMPC)
TWIM_SDA: IC1.B1 (SDA), IC2.32 (MISO/SDA), IC3.14 (SDA), J4.13, O1.11 (D1), R4.2, U2.8 (P1.07/AIN3/TAMPC)
VBUS: C3.1, IC4.17 (VBUS), J5.2

Notes on the sheet:
64 x 128 SH1107 OLED
I2C Address: 80 (decimal)
Damping Resistors
Matching Network
8.7V Boost Converter
I2C Address: 106 (decimal)
Buttons
To pin 49 ONLY
Accelerometer
Power
MCU
Haptic Feedback
To pin 32 ONLY on TOP layer
ONLY ground on bottom layer
Antenna Matching Network
Li-Po Charger + 3.0V Output
Debug Pins
5v In
NFC Controller
EMC filter
Voltage Divider
Remove 2.2uF capacitor from VDD_AM if using Active Wave Shaping
I2C Address: 60 (decimal) (subject to change)

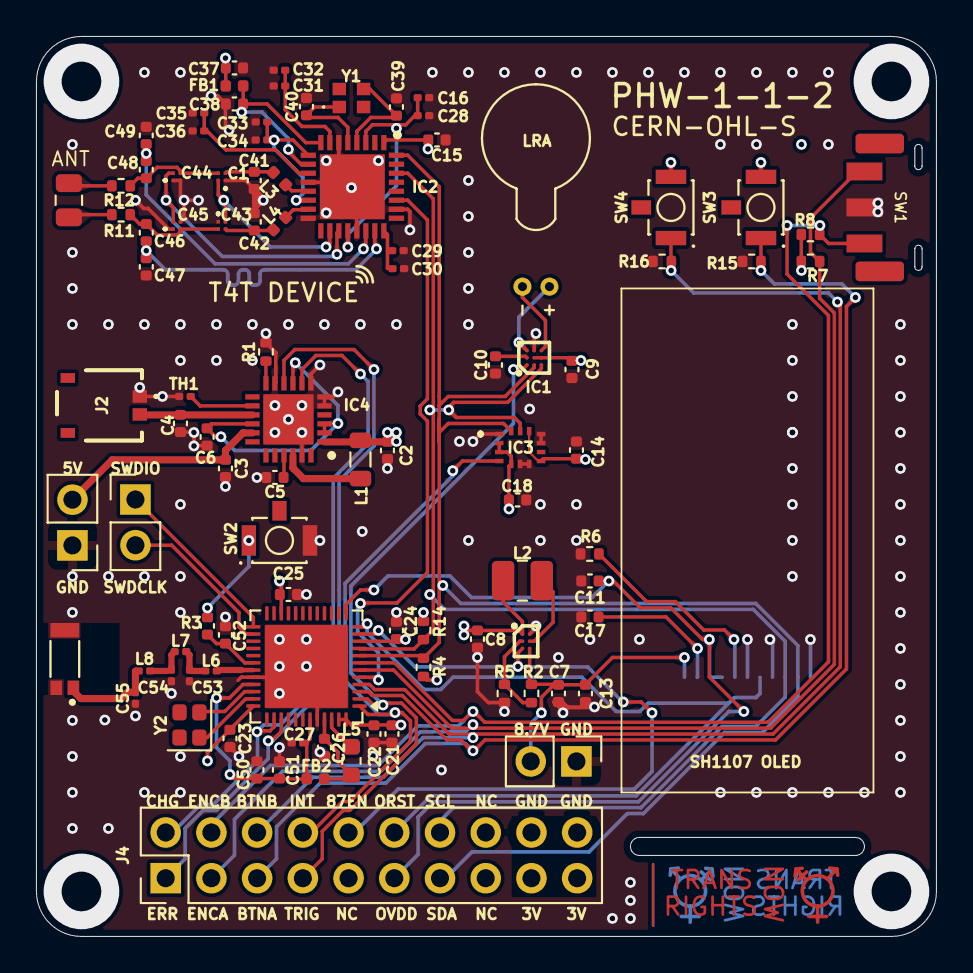
[picture p19: board watch.kicad_pcb from above]

Board: 4 copper layers, 50.0 x 50.0 mm, 99 parts (0 on the bottom side), 64 nets.

Other parts of the board:
TRNSRTS: Trans Rights now Front
TRNSRTS#2: Trans Rights now Back
