plumpastry/PHW/(commit log)

2026-02-17 Initial File Commit
    [212134-0002.stp, 2121340002.psm, B3U-1100P.step, CX90B-16P1.step, DRV2625YFFR.stp, EC05E1220202.stp, EDI2CAP.CFG, HD-LA0503-LW28.step]
2026-02-17 Added Interactive BOM
    [pcb_bom.xlsx, watch-dev.kicad_sch]
2026-03-19 Initial firmware setup
    Added hello world board firmware and gitignore
2026-03-20 Initial DRV2625 driver
    Barebones DRV2625 driver library added
