plumpastry/PHW/(notices)

Notices in the files:
nfc-watch/hardware/watch.kicad_pcb:
CERN-OHL-S
